Tertho1/IoT-Smart-Home/Smart_Home_Client_Design_ESP32_v1_2.docx

# IoT-BASED SMART HOME MONITORING

# AND AUTOMATION SYSTEM

Client Design & Implementation Specification

Controller: ESP32 DevKit V1

Prototype type: Low-voltage physical smart-home model

Target hardware budget: approximately BDT 4,000-5,000

Version: 1.2 (revised)

Purpose: A practical final-year IoT prototype combining environmental monitoring, basic automation, home security, gas/smoke warning, and phone-based control.

# Revision Notes (v1.1 -> v1.2)

One correction applied in this revision:

- Section 5 (Physical House Design) redrawn to match the confirmed traffic flow: the main door sits at the FRONT of the house and opens directly into the living room. From the living room, occupants branch into the bedroom or the kitchen — neither room is entered directly from outside. The kitchen occupies the rear-left corner of the house, so its exhaust fan vents through the BACK wall of the house rather than a side wall. No GPIO, wiring, or automation logic changed — this is a physical layout correction only.

# Revision Notes (v1.0 -> v1.1)

Three corrections identified during a feasibility review, applied throughout this document:

- GPIO 5 is an ESP32 boot-strapping pin. Reassigned Relay IN1 (Living Room Light) to GPIO 13 to avoid relay chatter/flicker on power-up or reset.
- Added an explicit step to confirm whether the 4-channel relay module is active-HIGH or active-LOW before writing control code or wiring loads — most budget modules are active-LOW, and getting this backwards can power on every load the instant the ESP32 boots.
- Added a verification step to confirm PIR module output voltage (should be 3.3V logic) with a multimeter before connecting to ESP32 GPIO, since ESP32 pins are not 5V-tolerant.

# 1. Project Overview

This project is a compact ESP32-based smart-home prototype designed specifically for a tight hardware budget. The physical model contains a living room, bedroom, kitchen and main door. Sensors are installed in the relevant rooms, while the ESP32, breadboard and relay module form a central control unit.

The system provides both automatic operation and manual control. Sensor data are read by the ESP32, automation rules are executed locally, and the ESP32 exposes a Wi-Fi interface/dashboard that can be opened from a phone on the same network.

- Temperature and humidity monitoring using DHT11.
- Motion detection in living room and bedroom using two PIR sensors.
- Automatic lighting using PIR + LDR logic.
- Temperature-based fan automation.
- Main-door open/closed monitoring using a magnetic reed switch.
- Gas/smoke threshold monitoring in the kitchen using MQ-2.
- Buzzer warning for security/gas events.
- Kitchen exhaust fan automation.
- Manual ON/OFF control of lights and fans from a phone through Wi-Fi.
- Live status dashboard for sensor and actuator states.

# 2. System Architecture

The house contains the sensors and low-voltage loads. Sensor signals return to the ESP32. The relay module switches the 5V DC lights/fans, while the phone communicates with the ESP32 over Wi-Fi.

PHONE / WEB DASHBOARD

Wi-Fi

v

ESP32

+----+-----------------------+

Sensors Relay outputs Buzzer

| +-- Living Light

| +-- Bedroom Light

| +-- Room Fan

| +-- Kitchen Exhaust

+-- DHT11

+-- PIR x2

+-- LDR x2

+-- MQ-2

+-- Door Reed Switch

# 3. Final Feature Scope

Feature | Input | Output / Result | Control
Temperature & humidity | DHT11 | Live readings | Monitoring
Automatic room light | PIR + LDR | Light ON/OFF | Automatic + phone
Room fan | DHT11 | Fan ON/OFF | Automatic + phone
Door security | Reed switch | Door status + buzzer | Automatic + monitoring
Gas/smoke safety | MQ-2 | Warning + exhaust + buzzer | Automatic + monitoring
Phone control | Wi-Fi | Light/fan/exhaust commands | Manual
Dashboard | ESP32 data | Live sensor/status display | Phone/laptop

# 4. Complete Hardware / BOM

The following is the recommended minimum hardware set. It is intentionally kept small enough for the target budget.

Component | Qty | Purpose
ESP32 DevKit V1 | 1 | Main controller + Wi-Fi
DHT11 module | 1 | Temperature/humidity
HC-SR501 PIR sensor | 2 | Motion detection
LDR/photoresistor | 2 | Ambient light measurement
10kΩ resistor | 2 | LDR voltage dividers
MQ-2 gas/smoke sensor module | 1 | Kitchen gas/smoke indication
10kΩ resistor | 1 | MQ-2 output divider
20kΩ resistor | 1 | MQ-2 output divider
Magnetic reed switch | 1 | Main-door state
4-channel 5V relay module | 1 | Switch four low-voltage loads
5V mini DC fan | 2 | Room fan + kitchen exhaust
5V LED light/module | 2-4 | Living/bedroom lights; optional kitchen light
Small active buzzer | 1 | Alarm
830-point breadboard | 1 | Central prototype wiring
Jumper wire set | 1 set | Interconnections
5V 2A DC power supply | 1 | Prototype power
USB cable for ESP32 | 1 | Programming/serial
Foam board/cardboard + base | 1 set | House model
Glue, tape, paper, paint | 1 set | Model finishing

# 5. Physical House Design

[REV 1.2] Redrawn to match the confirmed circulation: the main door is on the FRONT wall and opens straight into the living room — it is the only way into the house. From the living room, the layout branches into two directions: sideways into the bedroom, and rearward into the kitchen. Nobody enters the bedroom or kitchen directly from outside. The kitchen sits in the rear-left corner of the house, so its exhaust fan discharges through the house's BACK wall.

## 5.1 Room-to-room circulation

- Front wall: main door (with the reed switch) — the sole entry point.
- Main door → living room (direct entry).
- Living room → kitchen (rearward, left side of house).
- Living room → bedroom (sideways, right side of house).
- Kitchen occupies the rear-left corner; its exhaust fan vents through the house's back (rear) wall.
- Bedroom runs the full depth of the right-hand side of the house, reached only through the living room.

## 5.2 Top-down floor plan

BACK OF HOUSE

(kitchen exhaust vents here)

^

+---------------------+---------------------+

| KITCHEN | |

| MQ-2 / Exhaust / | |

| Buzzer / Stove | BEDROOM |

| | PIR2 / LDR2 / |

+---------------------+ Light |

| LIVING ROOM | (reached only via |

| PIR1 / LDR1 / | the living room) |

| DHT11 / Light / | |

| Fan | |

+----------+----------+----------------------+

| Door| <- Reed switch

FRONT OF HOUSE (main entrance)

Arrows of movement: Front door → Living room → (Kitchen or Bedroom). Kitchen exhaust air exits through the back wall of the house, which forms the kitchen's rear wall.

## 5.3 Build notes

- Keep the electronics (ESP32 + breadboard + relay module) in a protected area underneath or behind the house, near the kitchen/rear side to shorten the exhaust-fan and MQ-2 wiring runs.
- Run sensor wires through small hidden holes/channels in the model walls.
- Keep the MQ-2 near the kitchen/stove model, but do not expose it to unsafe flames or real gas.
- Use only low-voltage 5V DC loads in the student prototype.
- Use labels on the model: PIR, LDR, DHT11, MQ-2, Door Sensor, Light, Fan, Exhaust.
- Physically confirm the kitchen exhaust fan opening lines up with the back wall cut-out before gluing the model together.

# 6. Exact ESP32 Pin Configuration

[REV 1.1] Relay IN1 (Living Room Light) moved from GPIO 5 to GPIO 13 — GPIO5 is a boot-strapping pin and can cause the relay to click/flicker on every power-up or reset.

ESP32 Pin | Connected Component | Signal Type | Notes
GPIO 4 | DHT11 DATA | Digital I/O | Temperature/humidity data
GPIO 27 | PIR #1 OUT | Digital input | Living room motion
GPIO 26 | PIR #2 OUT | Digital input | Bedroom motion
GPIO 25 | Reed switch | Digital input | Use INPUT_PULLUP
GPIO 34 | LDR #1 midpoint | ADC input | Living room light level; input-only
GPIO 35 | LDR #2 midpoint | ADC input | Bedroom light level; input-only
GPIO 32 | MQ-2 AO via divider | ADC1 input | Gas/smoke level; protected
GPIO 13 | Relay IN1 | Digital output | Living room light (moved from GPIO5)
GPIO 18 | Relay IN2 | Digital output | Bedroom light
GPIO 19 | Relay IN3 | Digital output | Room fan
GPIO 21 | Relay IN4 | Digital output | Kitchen exhaust
GPIO 23 | Buzzer control | Digital output | Alarm
3.3V | DHT11 + LDR circuits | Power | Do not use 5V for LDR divider
VIN/5V | 5V input/rail | Power | Use regulated 5V
GND | Common ground | Power | All modules share ground

Why these ADC pins? GPIO 32, 34 and 35 are on the ESP32 ADC1 group, which is preferable when Wi-Fi is active. GPIO 34 and 35 are input-only, which is appropriate for the LDR measurements.

Why GPIO 13 for the relay? GPIO 5, 0, 2, 12 and 15 are boot-strapping pins that ESP32 samples during reset/power-up; driving a relay from one of them can cause a brief, unwanted click on every boot. GPIO 13 has no strapping function and is safe for a relay output.

# 7. Sensor-by-Sensor Wiring

## 7.1 DHT11

DHT11 ESP32

VCC ----------------> 3.3V

DATA ----------------> GPIO 4

GND ----------------> GND

If using a bare DHT11 sensor, add a 4.7kΩ-10kΩ pull-up from DATA to 3.3V. Most DHT11 breakout modules already include the pull-up.

Place DHT11 in the living room or a central indoor position. Avoid placing it directly beside the fan, MQ-2 heater, or power regulator.

## 7.2 PIR #1 – Living Room

PIR #1 ESP32

VCC ----------------> 5V

OUT ----------------> GPIO 27

GND ----------------> GND

## 7.3 PIR #2 – Bedroom

PIR #2 ESP32

VCC ----------------> 5V

OUT ----------------> GPIO 26

GND ----------------> GND

[REV 1.1] Before wiring either PIR OUT pin to the ESP32, measure its output with a multimeter (motion vs. no motion). It should read close to 3.3V logic. ESP32 GPIOs are not 5V-tolerant; some PIR clones do not regulate their output down from the 5V rail.

## 7.4 LDR #1 – Living Room

3.3V

LDR

+--------------> GPIO 34

10kΩ

GND

Bright room -> higher ADC reading with this arrangement. Dark room -> lower ADC reading.

The LDR is not normally connected like a 3-pin sensor module. It forms a voltage divider with the 10kΩ resistor.

## 7.5 LDR #2 – Bedroom

3.3V

LDR

+--------------> GPIO 35

10kΩ

GND

## 7.6 MQ-2 – Kitchen

MQ-2 module

VCC ---------> 5V

GND ---------> GND

AO --[10kΩ]--+------> GPIO 32

[20kΩ]

GND

IMPORTANT: Do not connect a potentially 5V MQ-2 AO directly to the ESP32 ADC. The 10kΩ/20kΩ divider scales a 5V signal to about 3.33V.

Use the MQ-2 as a relative gas/smoke threshold sensor for the prototype. It should not be presented as a calibrated ppm gas analyzer.

## 7.7 Magnetic Reed Switch – Main Door

ESP32 GPIO 25

[ REED SWITCH ]

GND

Software: pinMode(25, INPUT_PULLUP);

The magnet is attached to the door; the reed switch is fixed to the frame. The software interprets the switch state as OPEN/CLOSED.

# 8. Relay and Appliance Wiring

The ESP32 GPIO pins should control the relay inputs. The relay contacts then switch the 5V DC loads. Do not power a fan or lamp directly from an ESP32 GPIO.

[REV 1.1] Relay CH1 control moved from GPIO 5 to GPIO 13 (see Section 6).

Relay | ESP32 control | Load | Room
CH1 / IN1 | GPIO 13 | 5V Living Room Light | Living room
CH2 / IN2 | GPIO 18 | 5V Bedroom Light | Bedroom
CH3 / IN3 | GPIO 19 | 5V Mini Fan | Living room / room ventilation
CH4 / IN4 | GPIO 21 | 5V Mini Fan | Kitchen exhaust

ESP32 4-CHANNEL RELAY

GPIO 13 -------------> IN1

GPIO 18 -------------> IN2

GPIO 19 -------------> IN3

GPIO 21 -------------> IN4

GND -------------> GND

5V -------------> VCC

## RELAY CONTACT SIDE (5V DC loads)

5V --> CH1 COM

CH1 NO --> Living Light + --> GND

5V --> CH2 COM

CH2 NO --> Bedroom Light + --> GND

5V --> CH3 COM

CH3 NO --> Room Fan + ---------> GND

5V --> CH4 COM

CH4 NO --> Kitchen Exhaust + -> GND

NO means Normally Open. With this arrangement, a load is OFF when the relay is not energized and turns ON when the relay closes.

IMPORTANT — confirm trigger polarity before coding: most budget 4-channel relay modules are active-LOW (a LOW signal on IN1-IN4 energizes the relay, HIGH de-energizes it), not active-HIGH. Before wiring any load, power the relay board alone and test each IN pin with the ESP32: verify which logic level actually closes the relay. If the board is active-LOW and the firmware defaults every relay pin to LOW at boot (the common Arduino default before setup() runs), every load will briefly power on at startup. Set all relay control pins HIGH (off, for active-LOW boards) as the very first line in setup(), before any other initialization.

Relay-board note: choose a 5V 4-channel relay module whose input circuitry reliably accepts 3.3V logic. Some relay boards are designed around 5V logic and may not trigger reliably from ESP32 GPIO levels. If the selected board is not 3.3V-compatible, use a proper transistor/driver interface.

# 9. Buzzer

ESP32 GPIO 23 ---------> Buzzer control/input

ESP32 GND ---------> Buzzer GND

For a higher-current 5V buzzer, use an NPN transistor driver and a suitable base resistor rather than driving it directly from GPIO 23.

For the low-cost prototype, a small active buzzer module is preferred because the software only needs to turn it ON/OFF.

# 10. Breadboard Layout

The breadboard is the central prototyping area. The PIRs, reed switch and MQ-2 can physically sit in the house and connect back to this board with jumper wires.

- Place the ESP32 across the breadboard center gap.
- Use one rail for 5V and one for common GND.
- Use a separate 3.3V rail/section for the two LDR voltage dividers.
- Place the two 10kΩ LDR resistors close to their corresponding LDR signal nodes.
- Place the MQ-2 10kΩ/20kΩ divider close to the ESP32 ADC input.
- Keep relay/load wires physically separated from the small sensor signal wires where practical.
- Label each wire at both ends to make troubleshooting easier.

# 11. Room-Wise Design

## 11.1 Living Room

Item | Connection | Function
PIR #1 | GPIO 27 | Detect person/movement
LDR #1 | GPIO 34 | Measure room brightness
DHT11 | GPIO 4 | Temperature/humidity
Light | Relay CH1 / GPIO 13 | Automatic/manual lighting
Fan | Relay CH3 / GPIO 19 | Temperature/manual ventilation

Automatic light rule: if motion is detected AND the LDR indicates that the room is dark, turn the living-room light ON. After a configurable timeout with no motion, turn it OFF.

## 11.2 Bedroom

Item | Connection | Function
PIR #2 | GPIO 26 | Detect movement
LDR #2 | GPIO 35 | Measure brightness
Light | Relay CH2 / GPIO 18 | Automatic/manual lighting

Use the same PIR + LDR logic as the living room. The threshold and timeout should be software-configurable.

## 11.3 Kitchen

Item | Connection | Function
MQ-2 | GPIO 32 via divider | Gas/smoke threshold
Exhaust fan | Relay CH4 / GPIO 21 | Automatic/manual ventilation
Buzzer | GPIO 23 | Gas warning

When the MQ-2 reading crosses the configured threshold, the system can activate the kitchen exhaust and buzzer. The threshold should be calibrated experimentally in clean air and then tested using safe, non-flame demonstration conditions.

## 11.4 Main Door

Item | Connection | Function
Magnetic reed switch | GPIO 25 + GND | Open/closed detection
Buzzer | GPIO 23 | Security warning when armed
Dashboard | Wi-Fi | Door status

# 12. Automation Logic

## 12.1 Lighting

IF mode = AUTO:

IF PIR = MOTION AND LDR = DARK:

LIGHT = ON

start/restart inactivity timer

IF no motion for configured timeout:

LIGHT = OFF

IF mode = MANUAL:

phone command controls LIGHT

## 12.2 Temperature-Based Fan

IF mode = AUTO:

IF temperature >= HIGH_TEMP:

FAN = ON

IF temperature <= LOW_TEMP:

FAN = OFF

Use two thresholds (hysteresis) instead of one threshold to prevent rapid ON/OFF switching.

Example starting values: HIGH_TEMP = 30°C and LOW_TEMP = 28°C. These are demonstration settings, not universal comfort limits, and should be configurable from software.

## 12.3 Door Security

IF security_mode = ARMED:

IF door changes to OPEN:

BUZZER = ON

dashboard = "DOOR OPEN / ALERT"

IF security_mode = DISARMED:

monitor door state but do not trigger alarm

## 12.4 Gas/Smoke Safety

IF MQ2_value >= GAS_THRESHOLD:

BUZZER = ON

KITCHEN_EXHAUST = ON

dashboard = "GAS/SMOKE WARNING"

ELSE:

warning state = normal

MQ-2 readings are strongly affected by sensor warm-up, environment and the particular module. Use a calibrated project-specific threshold rather than claiming an exact gas concentration.

# 13. Phone-Based Monitoring and Control

The ESP32 includes Wi-Fi, so a separate Bluetooth module is not required. The recommended low-cost implementation is a responsive web dashboard served by a lightweight local server or directly by the ESP32.

PHONE

| Wi-Fi

v

ESP32

+-- GET/POST or WebSocket commands

+-- sensor readings

+-- actuator status

Dashboard controls:

- AUTO / MANUAL
- Living Light ON/OFF
- Bedroom Light ON/OFF
- Room Fan ON/OFF
- Exhaust ON/OFF
- Security ARM/DISARM

For the simplest version, use a web page that can be opened from the phone browser. A separate Android application is not necessary for the prototype.

# 14. Dashboard Screen Specification

+---------------------------------------+

| SMART HOME |

+---------------------------------------+

| Temperature : 28.4 C |

| Humidity : 63 % |

| Motion : Living / None |

| Door : CLOSED |

| Gas : NORMAL |

+---------------------------------------+

| Living Light [ ON ] |

| Bedroom Light [ OFF ] |

| Room Fan [ ON ] |

| Kitchen Exhaust[ OFF ] |

+---------------------------------------+

| Mode: AUTO |

| Security: ARMED |

+---------------------------------------+

# 15. Master Wiring Summary

[REV 1.1] GPIO5 updated to GPIO13 for the living room light relay in the diagram below.

ESP32 DEVKIT V1

+-----------------+--------------------+

SENSOR INPUTS RELAY OUTPUTS ALARM

+- GPIO4 <- DHT11 | +- GPIO23 -> Buzzer

+- GPIO27 <- PIR1 |

+- GPIO26 <- PIR2 | GPIO13 -> CH1 -> Living Light

+- GPIO25 <- Door | GPIO18 -> CH2 -> Bedroom Light

+- GPIO34 <- LDR1 | GPIO19 -> CH3 -> Room Fan

+- GPIO35 <- LDR2 | GPIO21 -> CH4 -> Kitchen Exhaust

+- GPIO32 <- MQ2 |

Power:

- 5V -> ESP32 VIN/5V, relay VCC, PIR VCC, MQ-2 VCC, 5V loads
- 3.3V -> DHT11 (recommended), LDR dividers
- GND -> common ground for ESP32 and all modules

LDR1: 3.3V -> LDR -> ADC node GPIO34 -> 10kΩ -> GND

LDR2: 3.3V -> LDR -> ADC node GPIO35 -> 10kΩ -> GND

MQ2: AO -> 10kΩ -> ADC node GPIO32 -> 20kΩ -> GND

# 16. Recommended Build Sequence

- Build the ESP32 + breadboard power rails only. Confirm 5V and 3.3V with a multimeter.
- Install the ESP32 and upload a basic test program.
- Connect DHT11 and verify temperature/humidity serial output.
- Connect PIR #1 and PIR #2 and verify motion detection (check output voltage first — see Section 7.2/7.3).
- Build and test both LDR voltage dividers.
- Connect the MQ-2 through the 10kΩ/20kΩ divider and observe ADC values after warm-up.
- Connect the reed switch and verify door OPEN/CLOSED state.
- Connect the relay module and test each channel with a low-voltage test LED/load — confirm active-HIGH vs active-LOW polarity first (see Section 8).
- Connect the two 5V fans and lights through the relay contacts.
- Add the buzzer and verify alarm logic.
- Implement automatic rules one at a time.
- Add Wi-Fi and phone dashboard.
- Mount sensors in the physical house.
- Hide/organize wires and label the central electronics.
- Perform a complete end-to-end demonstration and document results.

# 17. Budget Strategy

The design is intentionally constrained to the client's maximum BDT 4,000-5,000 hardware budget. Actual local prices vary by seller and component quality, so the budget should be treated as a target rather than a guaranteed quote.

Budget group | Target allocation | What it covers
Controller + sensors | ~BDT 1,300-1,700 | ESP32, DHT11, PIRs, LDRs, MQ-2, reed switch
Relay + loads | ~BDT 700-1,000 | 4-channel relay, two mini fans, LEDs, buzzer
Breadboard + wiring | ~BDT 400-600 | Breadboard, jumpers, resistors, connectors
Power | ~BDT 200-300 | 5V supply and small power accessories
Physical model | ~BDT 900-1,300 | Foam board/cardboard, base, decoration, glue
Contingency | ~BDT 200-400 | Extra wire, failed components, finishing

Target total: approximately BDT 3,700-5,300. To stay strictly below BDT 5,000, use cardboard/foam board instead of acrylic, buy standard modules, and avoid optional features.

# 18. Features Deliberately Excluded to Protect the Budget

- ESP32-CAM / CCTV
- RFID access control
- Voice assistant integration
- OLED/LCD display
- Soil-moisture irrigation
- Water-level automation
- Separate Android application
- Multiple ESP32 boards
- Paid cloud services
- AI/ML prediction

These can be added later if the client increases the budget, but they are not necessary to demonstrate a credible final-year IoT smart-home prototype.

# 19. Electrical and Safety Notes

- Use a regulated 5V DC supply for the prototype.
- Keep the model's lights and fans at low-voltage DC; do not introduce 220V AC into the student prototype.
- Never connect a fan, motor or lamp directly to an ESP32 GPIO.
- Use the relay contacts to switch the 5V loads.
- Ensure all low-voltage grounds are common where required.
- Protect the ESP32 ADC pins from signals above 3.3V.
- MQ-2 modules can become hot during operation; mount them so they do not touch foam/cardboard directly.
- Do not use an open flame or deliberately create a gas leak for the MQ-2 demonstration.
- Check the relay board's input logic compatibility before final assembly.
- Disconnect power before changing wiring.

# 20. Client Deliverables

Deliverable | Included
Physical smart-home model | Yes
ESP32 control circuit on breadboard | Yes
Sensor integration | Yes
Relay-controlled lights/fans | Yes
Phone-accessible dashboard | Yes
Automatic control logic | Yes
Testing and debugging | Yes
Project documentation/report | Can be included as a separate deliverable
Presentation slides | Optional
Viva/demo preparation | Optional

# 21. Final Recommended Configuration

CONTROLLER

1 x ESP32 DevKit V1

SENSORS

1 x DHT11

2 x HC-SR501 PIR

2 x LDR + 2 x 10kΩ

1 x MQ-2 + 10kΩ/20kΩ protection divider

1 x Magnetic Reed Switch

ACTUATORS

1 x 4-channel 5V relay

2 x 5V mini DC fans

2-4 x 5V LED lights

1 x Small active buzzer

STRUCTURE

1 x Breadboard

Jumper wires

5V 2A power supply

Foam board/cardboard house model

ROOMS

Main Door -> Reed Switch (front wall, only entrance)

Living Room -> PIR + LDR + DHT11 + Light + Fan (entered from main door)

Bedroom -> PIR + LDR + Light (entered from living room)

Kitchen -> MQ-2 + Exhaust Fan + Buzzer (entered from living room; exhaust vents through back wall)

PHONE

Wi-Fi web dashboard

Monitoring + manual ON/OFF

AUTO/MANUAL modes

# 22. Acceptance / Demonstration Checklist

- ESP32 boots and connects to Wi-Fi.
- Dashboard opens successfully from a phone.
- Temperature and humidity update live.
- Living-room motion changes the PIR status.
- Bedroom motion changes the PIR status.
- Lights can be controlled manually from the phone.
- Automatic light logic responds to motion + darkness.
- Fan responds to temperature threshold.
- Door status changes when the model door opens/closes.
- Door security alarm can be demonstrated.
- MQ-2 reading changes during a safe demonstration.
- Kitchen exhaust activates on the configured gas/smoke threshold.
- Manual phone control can override automatic operation where designed.
- All wiring is labelled and physically secure.
- Relay polarity (active-HIGH/LOW) confirmed and all loads default OFF at boot.
- Physical circulation matches design: door -> living room -> kitchen/bedroom, exhaust through back wall.

# 23. Important Technical Clarifications

- GPIO 34 and GPIO 35 are input-only; they are used only for LDR ADC measurements.
- GPIO 32 is an ADC1 pin, so it remains suitable while Wi-Fi is active.
- The MQ-2 analog output must be voltage-limited before reaching an ESP32 ADC input if the module can output up to 5V.
- A normal LDR needs a voltage-divider circuit; it is not a digital sensor by itself.
- The second 5V mini fan is the kitchen exhaust fan; no third fan is required.
- The phone communicates with the ESP32 over Wi-Fi; it does not connect separately to each sensor.
- The relay switches the low-voltage appliance power; the ESP32 only supplies the relay control signal.
- GPIO 0, 2, 5, 12 and 15 are boot-strapping pins; avoid driving relay/actuator outputs from them where possible (see Section 6).
- Confirm relay module trigger polarity (active-HIGH vs active-LOW) before finalizing firmware; default all relay outputs to the OFF state as the first line of setup().
- Main door is the sole entrance, on the front wall, leading directly into the living room; kitchen and bedroom are reached only via the living room (see Section 5).

END OF CLIENT DESIGN SPECIFICATION

ESP32 • Monitoring • Automation • Security • Phone Control

Designed for a compact, low-cost final-year IoT prototype
