Tertho1/IoT-Smart-Home/(commit log)

2026-09-22 Initial Setup
    [BOM.csv]
2026-09-22 Fix ArduinoJson nullptr compile + flash baseline v1.3 + progress log
    [Smart_Home_ESP32_v1.3.ino]
2026-09-22 Add mDNS smarthome.local + fixed Serial links v1.4-mdns
    [Smart_Home_ESP32_v1.3.ino]
